cosmopotamian/scopefun-hardware/KiCadSource/file56A5A070.kicad_sch

## KiCad design KiCadSource/file56A5A070.kicad_sch (2025-03-08)

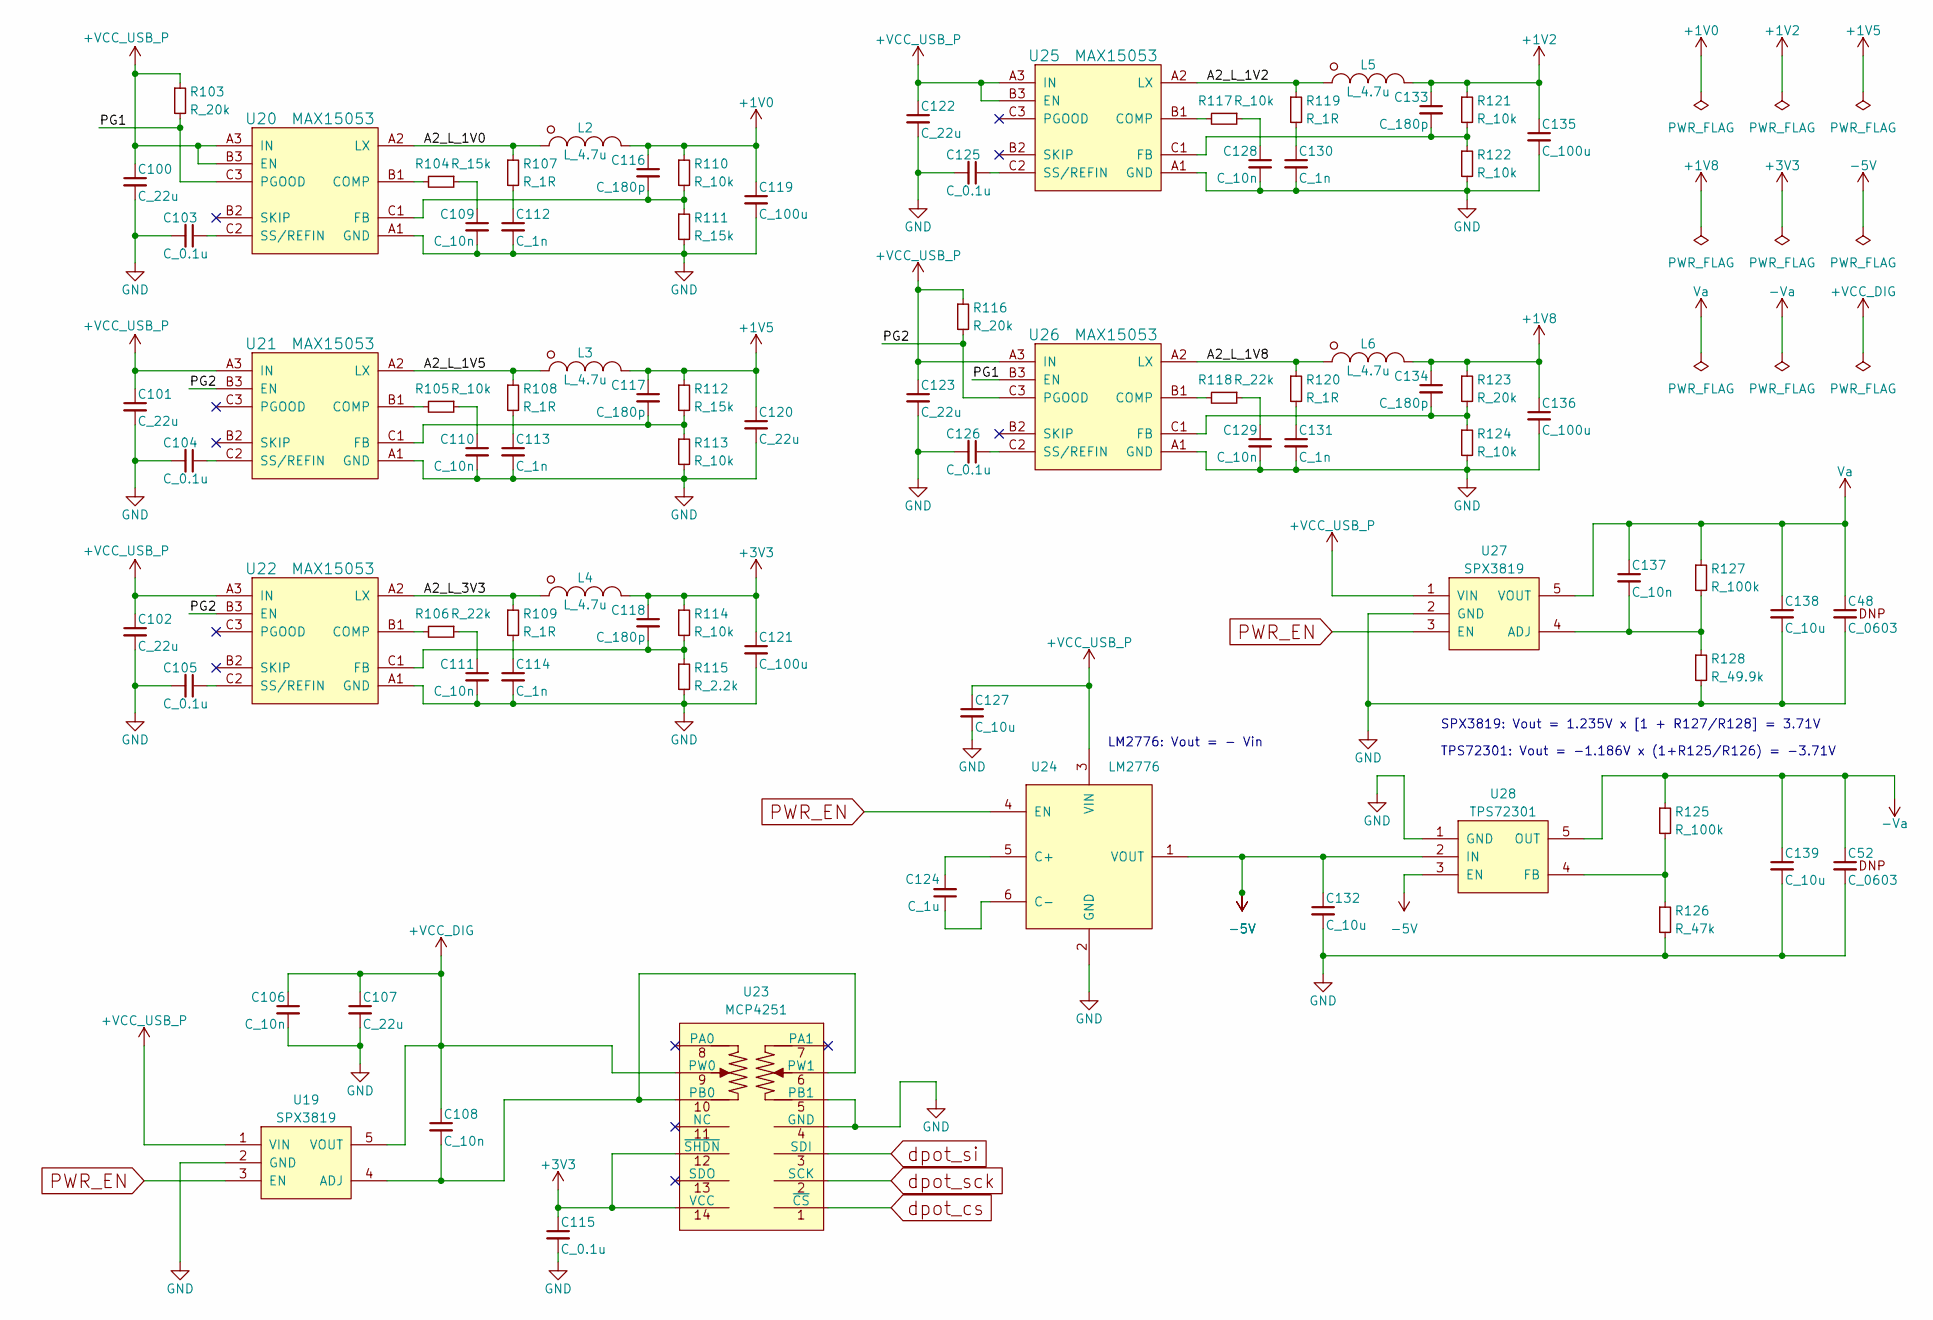
[picture p1: schematic file56A5A070.kicad_sch]

Parts:
C48, C52: C_0603
C100, C101, C102, C107, C120, C122, C123: C_22u; C_0805; MFG Part# LMK212BBJ226MG-T
C103, C104, C105, C115, C125, C126: C_0.1u; C_0603; MFG Part# C0603C104K4RACTU
C106: C_10n; C_0603; MFG Part# GCM188R72A103KA37J
C108, C109, C110, C111, C128, C129, C137: C_10n; C_0603; MFG Part# GRM1885C1H103JA01D
C112, C113, C114, C130, C131: C_1n; C_0603; MFG Part# C1608X7R1H102K080AE
C116, C117, C118, C133, C134: C_180p; C_0603; MFG Part# C0603C181J5GACTU
C119, C121, C135, C136: C_100u; C_1210; MFG Part# 12106D107MAT2A
C124: C_1u; C_0603; MFG Part# C0603C105K9PACTU
C127, C132, C138, C139: C_10u; C_0603; MFG Part# GRM188R60J106KE47D
L2, L3, L4, L5, L6: L_4.7u; L_NRS; MFG Part# NRS5030T4R7MMGJ
R103, R116, R123: R_20k; R_0603; MFG Part# ERJ-3EKF2002V
R104, R111, R112: R_15k; R_0603; MFG Part# ERJ-3EKF1502V
R105, R110, R113, R114, R117, R121, R122, R124: R_10k; R_0603; MFG Part# ERJ-3EKF1002V
R106, R118: R_22k; R_0603; MFG Part# ERJ-3EKF2202V
R107, R108, R109, R119, R120: R_1R; R_0603; MFG Part# ERJ-3GEYJ1R0V
R115: R_2.2k; R_0603; MFG Part# ERJ-3EKF2201V
R125, R127: R_100k; R_0603; MFG Part# ERJ-3EKF1003V
R126: R_47k; R_0603; MFG Part# ERJ-3EKF4702V
R128: R_49.9k; R_0603; MFG Part# ERJ-3EKF4992V
U19, U27: SPX3819; SOT23-5_EXAR; MFG Part# SPX3819M5-L/TR
U20, U21, U22, U25, U26: MAX15053; WLP-9; MFG Part# MAX15053EWL+T
U23: MCP4251; TSSOP14; MFG Part# MCP4251-503E/ST
U24: LM2776; SOT23-6; MFG Part# LM2776DBVR
U28: TPS72301; SOT23-5; MFG Part# TPS72301DBVR

Connections:
+1V0: C116.1, C119.1, L2.2, R110.1
+1V2: C133.1, C135.1, L5.2, R121.1
+1V5: C117.1, C120.1, L3.2, R112.1
+1V8: C134.1, C136.1, L6.2, R123.1
+3V3: C115.1, C118.1, C121.1, L4.2, R114.1, U23.12 (~SHDN), U23.14 (VCC)
+VCC_DIG: C106.1, C107.1, C108.1, U19.5 (VOUT), U23.9 (PW0)
+VCC_USB_P: C100.1, C101.1, C102.1, C122.1, C123.1, C127.1, R103.1, R116.1, U19.1 (VIN), U20.A3 (IN), U20.B3 (EN), U21.A3 (IN), U22.A3 (IN), U24.3 (VIN), U25.A3 (IN), U25.B3 (EN), U26.A3 (IN), U27.1 (VIN)
-5V: C132.1, U24.1 (VOUT), U28.2 (IN), U28.3 (EN)
-Va: C52.1, C139.1, R125.1, U28.5 (OUT)
A2_L_1V0: L2.1, R107.1, U20.A2 (LX)
A2_L_1V2: L5.1, R119.1, U25.A2 (LX)
A2_L_1V5: L3.1, R108.1, U21.A2 (LX)
A2_L_1V8: L6.1, R120.1, U26.A2 (LX)
A2_L_3V3: L4.1, R109.1, U22.A2 (LX)
GND: C48.2, C52.2, C100.2, C101.2, C102.2, C103.2, C104.2, C105.2, C106.2, C107.2, C109.2, C110.2, C111.2, C112.2, C113.2, C114.2, C115.2, C119.2, C120.2, C121.2, C122.2, C123.2, C125.2, C126.2, C127.2, C128.2, C129.2, C130.2, C131.2, C132.2, C135.2, C136.2, C138.2, C139.2, R111.2, R113.2, R115.2, R122.2, R124.2, R126.2, R128.2, U19.2 (GND), U20.A1 (GND), U21.A1 (GND), U22.A1 (GND), U23.4 (GND), U23.5 (PB1), U24.2 (GND), U25.A1 (GND), U26.A1 (GND), U27.2 (GND), U28.1 (GND)
unnamed: C103.1, U20.C2 (SS/REFIN)
unnamed: C104.1, U21.C2 (SS/REFIN)
unnamed: C105.1, U22.C2 (SS/REFIN)
unnamed: C108.2, U19.4 (ADJ), U23.6 (PW1), U23.10 (PB0)
unnamed: C109.1, R104.1
unnamed: C110.1, R105.1
unnamed: C111.1, R106.1
unnamed: C112.1, R107.2
unnamed: C113.1, R108.2
unnamed: C114.1, R109.2
unnamed: C116.2, R110.2, R111.1, U20.C1 (FB)
unnamed: C117.2, R112.2, R113.1, U21.C1 (FB)
unnamed: C118.2, R114.2, R115.1, U22.C1 (FB)
unnamed: C124.1, U24.6 (C-)
unnamed: C124.2, U24.5 (C+)
unnamed: C125.1, U25.C2 (SS/REFIN)
unnamed: C126.1, U26.C2 (SS/REFIN)
unnamed: C128.1, R117.1
unnamed: C129.1, R118.1
unnamed: C130.1, R119.2
unnamed: C131.1, R120.2
unnamed: C133.2, R121.2, R122.1, U25.C1 (FB)
unnamed: C134.2, R123.2, R124.1, U26.C1 (FB)
unnamed: C137.2, R127.2, R128.1, U27.4 (ADJ)
unnamed: R104.2, U20.B1 (COMP)
unnamed: R105.2, U21.B1 (COMP)
unnamed: R106.2, U22.B1 (COMP)
unnamed: R117.2, U25.B1 (COMP)
unnamed: R118.2, U26.B1 (COMP)
unnamed: R125.2, R126.1, U28.4 (FB)
PG1: R103.2, U20.C3 (PGOOD), U26.B3 (EN)
PG2: R116.2, U21.B3 (EN), U22.B3 (EN), U26.C3 (PGOOD)
PWR_EN: U19.3 (EN), U24.4 (EN), U27.3 (EN)
Va: C48.1, C137.1, C138.1, R127.1, U27.5 (VOUT)
dpot_cs: U23.1 (~CS)
dpot_sck: U23.2 (SCK)
dpot_si: U23.3 (SDI)

Notes on the sheet:
TPS72301: Vout = -1.186V x (1+R125/R126) = -3.71V
LM2776: Vout = - Vin
SPX3819: Vout = 1.235V x [1 + R127/R128] = 3.71V
