cosmopotamian/scopefun-hardware/KiCadSource/file56A1473D.kicad_sch

## KiCad design KiCadSource/file56A1473D.kicad_sch (2025-03-08)

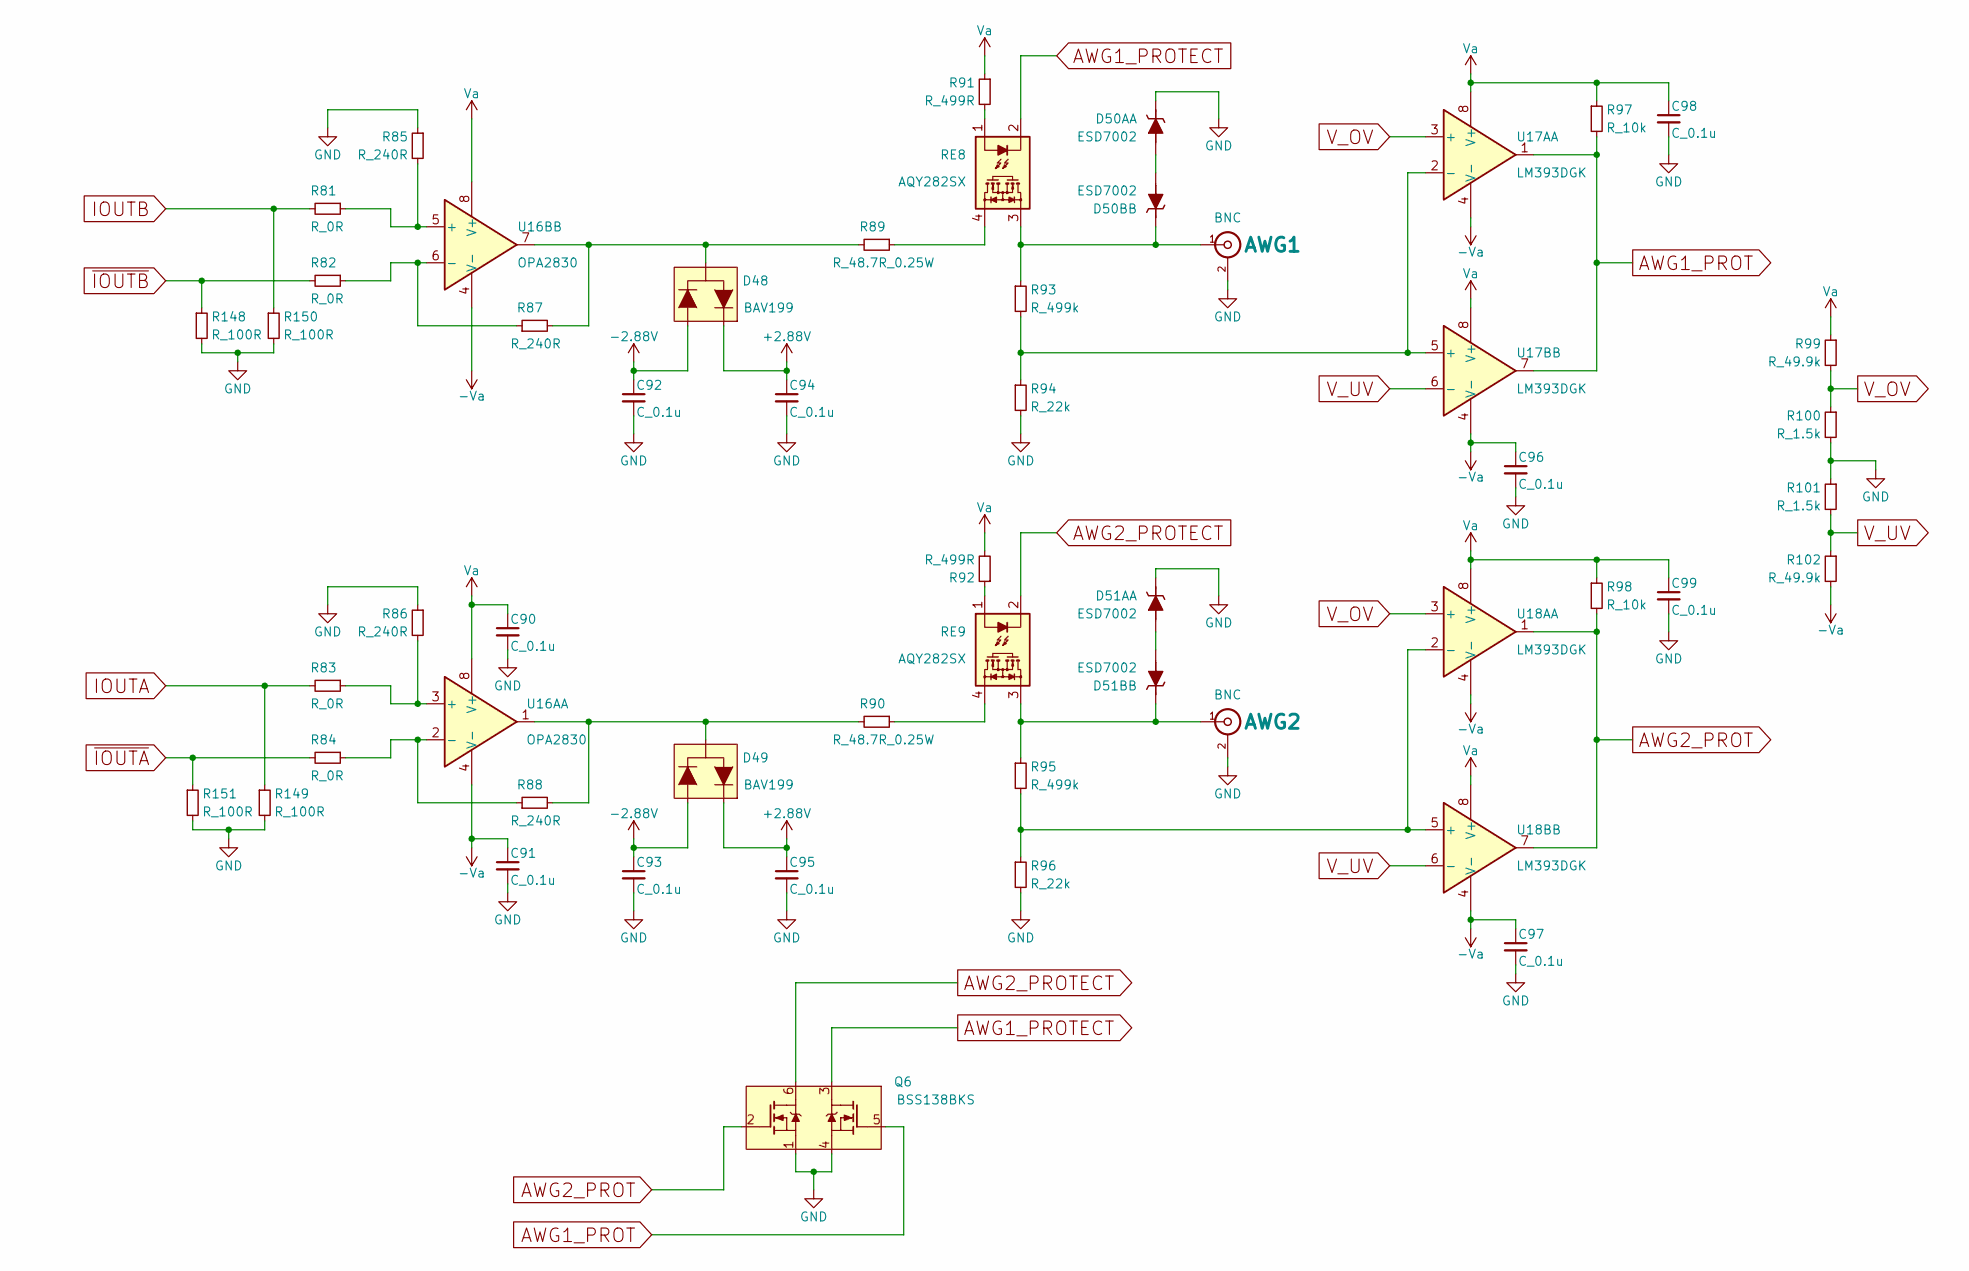
[picture p2: schematic file56A1473D.kicad_sch]

Parts:
AWG1, AWG2: BNC; BNC-5-1634556-0; MFG Part# 5-1634556-0
C90, C91, C92, C93, C94, C95, C96, C97, C98, C99: C_0.1u; C_0603; MFG Part# C0603C104K4RACTU
D48, D49: BAV199; SOT23; MFG Part# BAV199-7-F
D50A, D50B, D51A, D51B: ESD7002; SOT323; MFG Part# ESD7002WTT1G
Q6: BSS138BKS; SOT363; MFG Part# BSS138PS,115
R81, R82, R83, R84: R_0R; R_0603; MFG Part# RC0603JR-070RL
R85, R86, R87, R88: R_240R; R_0603; MFG Part# ERJ-3EKF2400V
R89, R90: R_48.7R_0.25W; R_1206; MFG Part# ERJ-8ENF48R7V
R91, R92: R_499R; R_0603; MFG Part# ERJ-3EKF4990V
R93, R95: R_499k; R_0603; MFG Part# ERJ-3EKF4993V
R94, R96: R_22k; R_0603; MFG Part# ERJ-3EKF2202V
R97, R98: R_10k; R_0603; MFG Part# ERJ-3EKF1002V
R99, R102: R_49.9k; R_0603; MFG Part# ERJ-3EKF4992V
R100, R101: R_1.5k; R_0603; MFG Part# ERJ-3EKF1501V
R148, R149, R150, R151: R_100R; R_0603; MFG Part# ERJ-3EKF1000V
RE8, RE9: AQY282SX; SOP-4; MFG Part# AQY282SX
U16A, U16B: OPA2830; TSSOP8; MFG Part# OPA2830IDGKT
U17A, U17B, U18A, U18B: LM393DGK; TSSOP8; MFG Part# LM393DGKR

Connections:
+2.88V: C94.1, C95.1, D48.2, D49.2
-2.88V: C92.1, C93.1, D48.1, D49.1
-Va: C91.1, C96.1, C97.1, R102.2, U16A.4 (V-), U16B.4 (V-), U17A.4 (V-), U17B.4 (V-), U18A.4 (V-), U18B.4 (V-)
AWG1_PROT: Q6.5 (G2), R97.2, U17A.1, U17B.7
AWG1_PROTECT: Q6.3 (D2), RE8.2
AWG2_PROT: Q6.2 (G1), R98.2, U18A.1, U18B.7
AWG2_PROTECT: Q6.6 (D1), RE9.2
GND: AWG1.2 (Ext), AWG2.2 (Ext), C90.2, C91.2, C92.2, C93.2, C94.2, C95.2, C96.2, C97.2, C98.2, C99.2, D50A.1 (C), D51A.1 (C), Q6.1 (S1), Q6.4 (S2), R85.1, R86.1, R94.2, R96.2, R100.2, R101.1, R148.2, R149.2, R150.2, R151.2
IOUTA: R83.2, R149.1
IOUTB: R81.2, R150.1
unnamed: AWG1.1 (In), D50B.2 (C), R93.1, RE8.3
unnamed: AWG2.1 (In), D51B.2 (C), R95.1, RE9.3
unnamed: D48.3, R87.2, R89.2, U16B.7
unnamed: D49.3, R88.2, R90.2, U16A.1
unnamed: D50A.3 (A), D50B.3 (A)
unnamed: D51A.3 (A), D51B.3 (A)
unnamed: R81.1, R85.2, U16B.5 (+)
unnamed: R82.1, R87.1, U16B.6 (-)
unnamed: R83.1, R86.2, U16A.3 (+)
unnamed: R84.1, R88.1, U16A.2 (-)
unnamed: R89.1, RE8.4
unnamed: R90.1, RE9.4
unnamed: R91.2, RE8.1
unnamed: R92.1, RE9.1
unnamed: R93.2, R94.1, U17A.2 (-), U17B.5 (+)
unnamed: R95.2, R96.1, U18A.2 (-), U18B.5 (+)
V_OV: R99.2, R100.1, U17A.3 (+), U18A.3 (+)
V_UV: R101.2, R102.1, U17B.6 (-), U18B.6 (-)
Va: C90.1, C98.1, C99.1, R91.1, R92.2, R97.1, R98.1, R99.1, U16A.8 (V+), U16B.8 (V+), U17A.8 (V+), U17B.8 (V+), U18A.8 (V+), U18B.8 (V+)
~IOUTA: R84.2, R151.1
~IOUTB: R82.2, R148.1
