cosmopotamian/scopefun-hardware/KiCadSource/file584EFEB1.kicad_sch

## KiCad design KiCadSource/file584EFEB1.kicad_sch (2025-03-08)

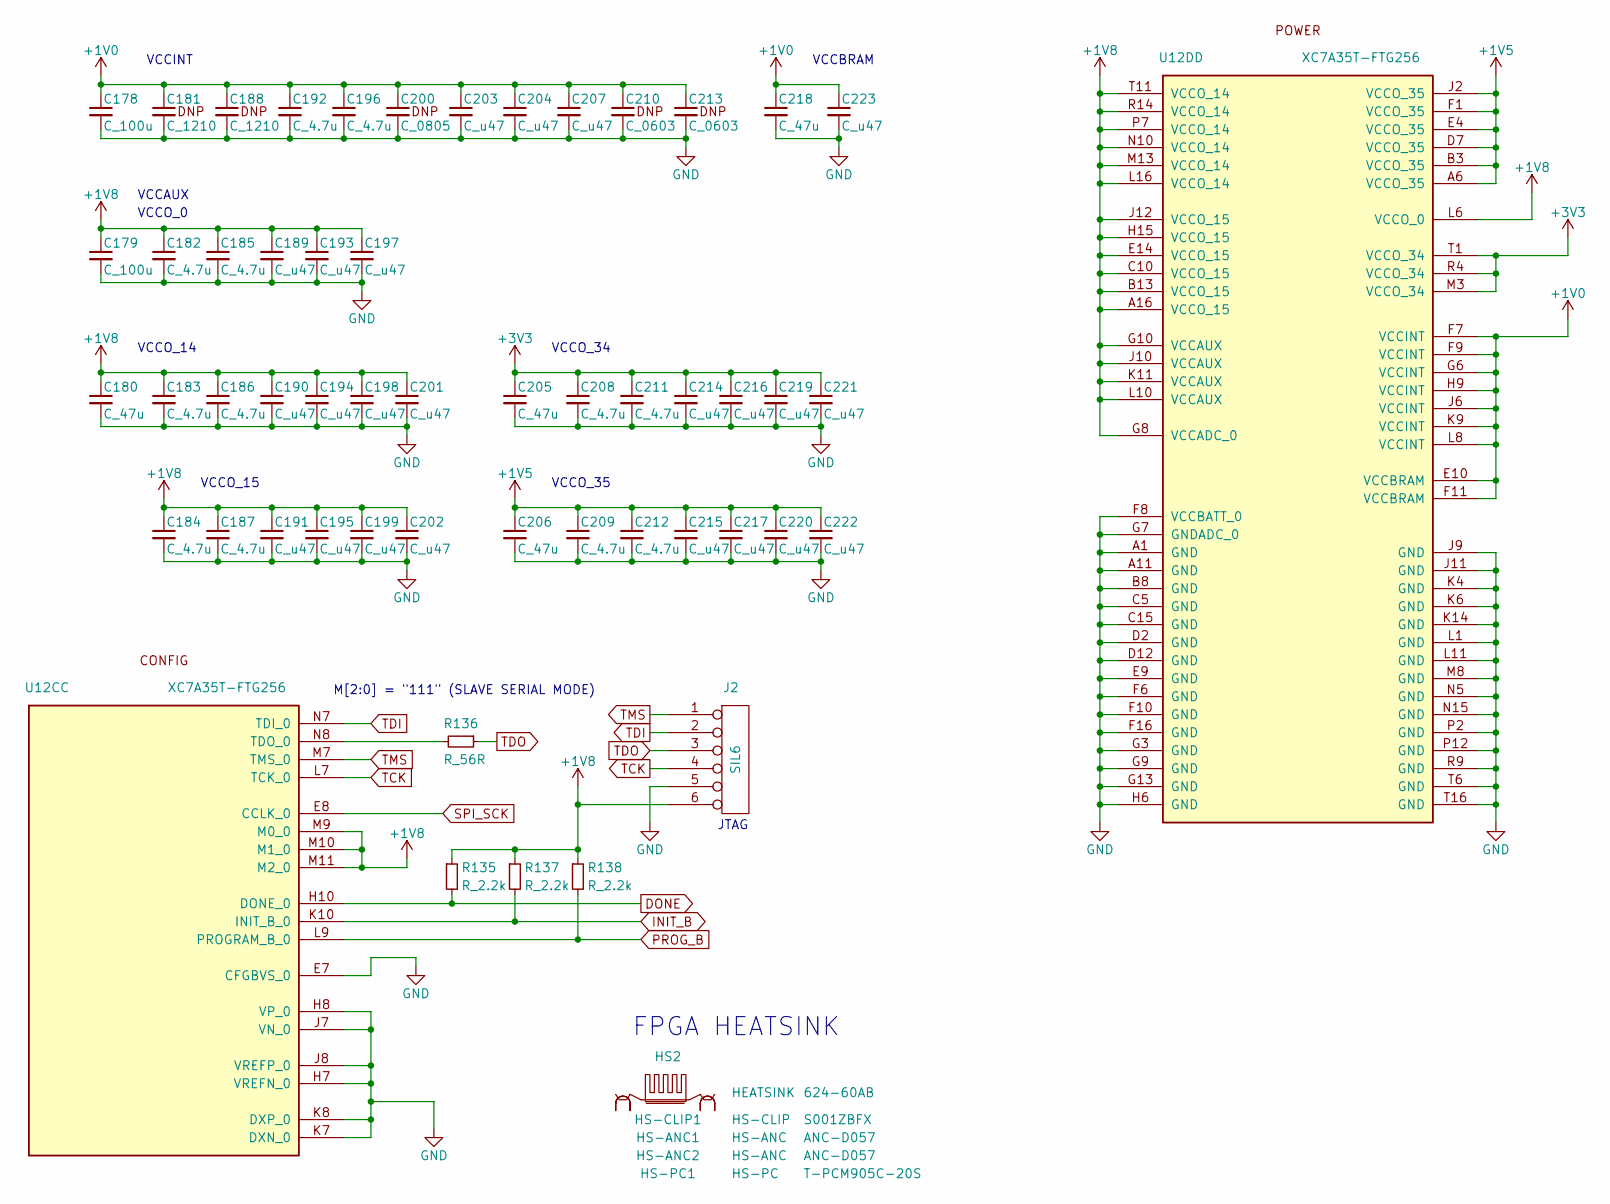
[picture p4: schematic file584EFEB1.kicad_sch]

Parts:
C178, C179: C_100u; C_1210; MFG Part# 12106D107MAT2A
C180, C205, C206, C218: C_47u; C_1210; MFG Part# LMK325BJ476MM-T
C181, C188: C_1210
C182, C183, C184, C185, C186, C187, C192, C196, C208, C209, C211, C212: C_4.7u; C_0805; MFG Part# C2012X7R1A475K125AC
C189, C190, C191, C193, C194, C195, C197, C198, C199, C201, C202, C203, C204, C207, C214, C215, C216, C217, C219, C220, C221, C222, C223: C_u47; C_0603; MFG Part# EMK107B7474KA-T
C200: C_0805
C210, C213: C_0603
HS2: HEATSINK; HS2; MFG Part# 624-60AB
HS-ANC1, HS-ANC2: HS-ANC; MFG Part# ANC-D057
HS-CLIP1: HS-CLIP; MFG Part# S001ZBFX
HS-PC1: HS-PC; MFG Part# T-PCM905C-20S
J2: SIL6; MFG Part# M20-9990645
R135, R137, R138: R_2.2k; R_0603; MFG Part# ERJ-3EKF2201V
R136: R_56R; R_0603; MFG Part# ERJ-3EKF56R0V
U12C, U12D: XC7A35T-FTG256; BGA256_FTG256; MFG Part# XC7A35T-2FTG256I

Connections:
+1V0: C178.1, C181.1, C188.1, C192.1, C196.1, C200.1, C203.1, C204.1, C207.1, C210.1, C213.1, C218.1, C223.1, U12D.E10 (VCCBRAM), U12D.F7 (VCCINT), U12D.F9 (VCCINT), U12D.F11 (VCCBRAM), U12D.G6 (VCCINT), U12D.H9 (VCCINT), U12D.J6 (VCCINT), U12D.K9 (VCCINT), U12D.L8 (VCCINT)
+1V5: C206.1, C209.1, C212.1, C215.1, C217.1, C220.1, C222.1, U12D.A6 (VCCO_35), U12D.B3 (VCCO_35), U12D.D7 (VCCO_35), U12D.E4 (VCCO_35), U12D.F1 (VCCO_35), U12D.J2 (VCCO_35)
+1V8: C179.1, C180.1, C182.1, C183.1, C184.1, C185.1, C186.1, C187.1, C189.1, C190.1, C191.1, C193.1, C194.1, C195.1, C197.1, C198.1, C199.1, C201.1, C202.1, J2.6, R135.1, R137.1, R138.1, U12C.M9 (M0_0), U12C.M10 (M1_0), U12C.M11 (M2_0), U12D.A16 (VCCO_15), U12D.B13 (VCCO_15), U12D.C10 (VCCO_15), U12D.E14 (VCCO_15), U12D.G8 (VCCADC_0), U12D.G10 (VCCAUX), U12D.H15 (VCCO_15), U12D.J10 (VCCAUX), U12D.J12 (VCCO_15), U12D.K11 (VCCAUX), U12D.L6 (VCCO_0), U12D.L10 (VCCAUX), U12D.L16 (VCCO_14), U12D.M13 (VCCO_14), U12D.N10 (VCCO_14), U12D.P7 (VCCO_14), U12D.R14 (VCCO_14), U12D.T11 (VCCO_14)
+3V3: C205.1, C208.1, C211.1, C214.1, C216.1, C219.1, C221.1, U12D.M3 (VCCO_34), U12D.R4 (VCCO_34), U12D.T1 (VCCO_34)
DONE: R135.2, U12C.H10 (DONE_0)
GND: C178.2, C179.2, C180.2, C181.2, C182.2, C183.2, C184.2, C185.2, C186.2, C187.2, C188.2, C189.2, C190.2, C191.2, C192.2, C193.2, C194.2, C195.2, C196.2, C197.2, C198.2, C199.2, C200.2, C201.2, C202.2, C203.2, C204.2, C205.2, C206.2, C207.2, C208.2, C209.2, C210.2, C211.2, C212.2, C213.2, C214.2, C215.2, C216.2, C217.2, C218.2, C219.2, C220.2, C221.2, C222.2, C223.2, J2.5, U12C.E7 (CFGBVS_0), U12C.H7 (VREFN_0), U12C.H8 (VP_0), U12C.J7 (VN_0), U12C.J8 (VREFP_0), U12C.K7 (DXN_0), U12C.K8 (DXP_0), U12D.A1 (GND), U12D.A11 (GND), U12D.B8 (GND), U12D.C5 (GND), U12D.C15 (GND), U12D.D2 (GND), U12D.D12 (GND), U12D.E9 (GND), U12D.F6 (GND), U12D.F8 (VCCBATT_0), U12D.F10 (GND), U12D.F16 (GND), U12D.G3 (GND), U12D.G7 (GNDADC_0), U12D.G9 (GND), U12D.G13 (GND), U12D.H6 (GND), U12D.J9 (GND), U12D.J11 (GND), U12D.K4 (GND), U12D.K6 (GND), U12D.K14 (GND), U12D.L1 (GND), U12D.L11 (GND), U12D.M8 (GND), U12D.N5 (GND), U12D.N15 (GND), U12D.P2 (GND), U12D.P12 (GND), U12D.R9 (GND), U12D.T6 (GND), U12D.T16 (GND)
INIT_B: R137.2, U12C.K10 (INIT_B_0)
unnamed: R136.2, U12C.N8 (TDO_0)
PROG_B: R138.2, U12C.L9 (PROGRAM_B_0)
SPI_SCK: U12C.E8 (CCLK_0)
TCK: J2.4, U12C.L7 (TCK_0)
TDI: J2.2, U12C.N7 (TDI_0)
TDO: J2.3, R136.1
TMS: J2.1, U12C.M7 (TMS_0)

Notes on the sheet:
VCCO_35
VCCO_14
FPGA HEATSINK
M[2:0] = "111" (SLAVE SERIAL MODE)
JTAG
VCCO_0
VCCINT
VCCO_34
VCCBRAM
VCCAUX
VCCO_15
