cosmopotamian/scopefun-hardware/KiCadSource/file5696EC3B.kicad_sch

## KiCad design KiCadSource/file5696EC3B.kicad_sch (2025-03-08)

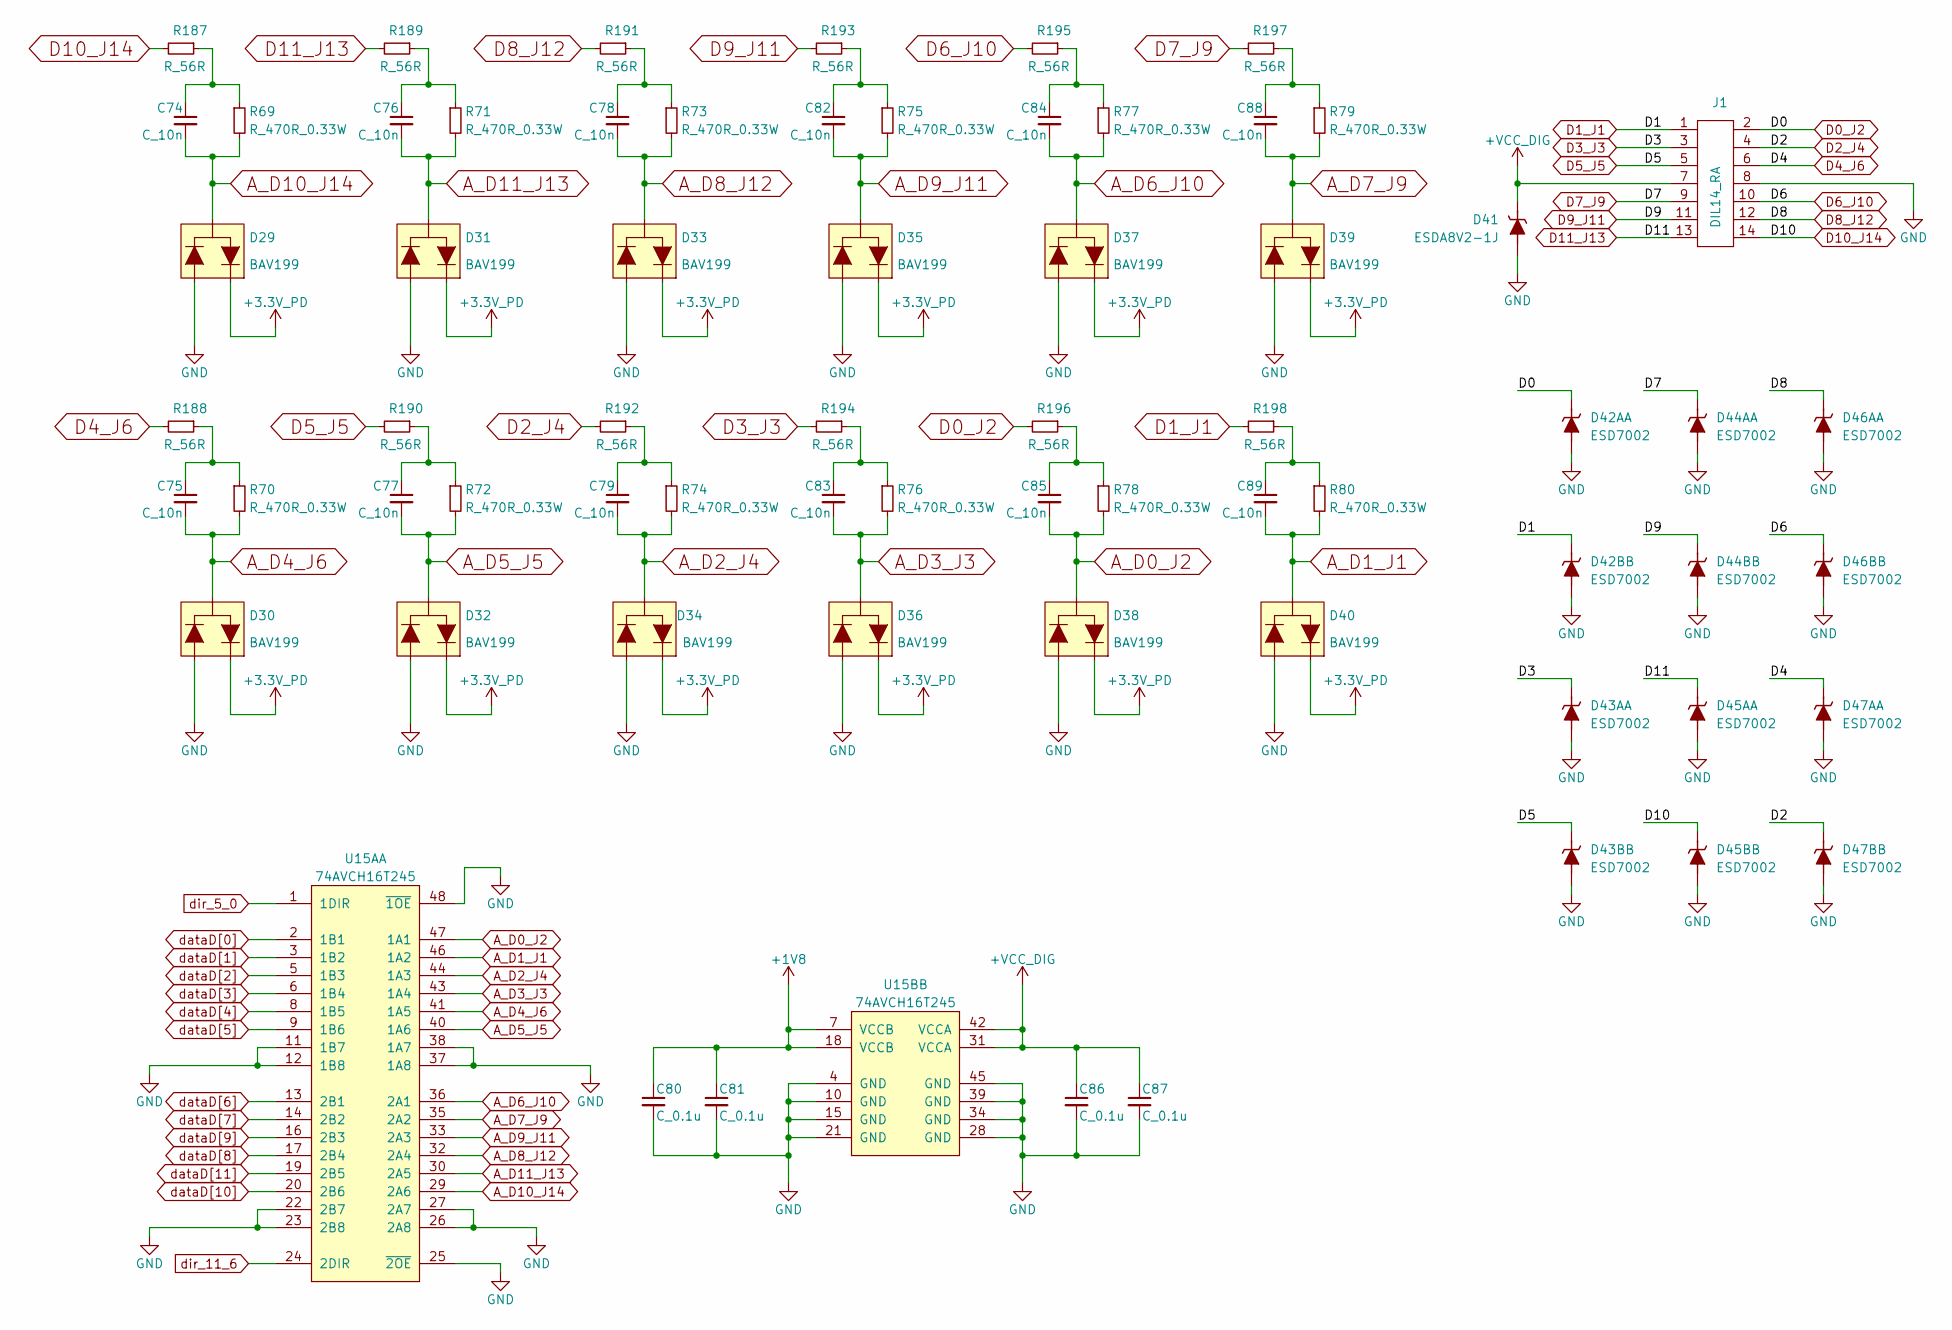
[picture p5: schematic file5696EC3B.kicad_sch]

Parts:
C74, C75, C76, C77, C78, C79, C82, C83, C84, C85, C88, C89: C_10n; C_0603; MFG Part# GCM188R72A103KA37J
C80, C81, C86, C87: C_0.1u; C_0603; MFG Part# C0603C104K4RACTU
D29, D30, D31, D32, D33, D34, D35, D36, D37, D38, D39, D40: BAV199; SOT23; MFG Part# BAV199-7-F
D41: ESDA8V2-1J; SOD323; MFG Part# ESDA8V2-1J
D42A, D42B, D43A, D43B, D44A, D44B, D45A, D45B, D46A, D46B, D47A, D47B: ESD7002; SOT323; MFG Part# ESD7002WTT1G
J1: DIL14_RA; MFG Part# 61201421721
R69, R70, R71, R72, R73, R74, R75, R76, R77, R78, R79, R80: R_470R_0.33W; R_0603; MFG Part# SG73P1JTTD4700F
R187, R188, R189, R190, R191, R192, R193, R194, R195, R196, R197, R198: R_56R; R_0603; MFG Part# ERJ-3EKF56R0V
U15A, U15B: 74AVCH16T245; TSSOP48; MFG Part# SN74AVCH16T245GR

Connections:
+1V8: C80.1, C81.1, U15B.7 (VCCB), U15B.18 (VCCB)
+3.3V_PD: D29.2, D30.2, D31.2, D32.2, D33.2, D34.2, D35.2, D36.2, D37.2, D38.2, D39.2, D40.2
+VCC_DIG: C86.1, C87.1, D41.1 (C), J1.7, U15B.31 (VCCA), U15B.42 (VCCA)
A_D0_J2: C85.2, D38.3, R78.2, U15A.47 (1A1)
A_D1_J1: C89.2, D40.3, R80.2, U15A.46 (1A2)
A_D2_J4: C79.2, D34.3, R74.2, U15A.44 (1A3)
A_D3_J3: C83.2, D36.3, R76.2, U15A.43 (1A4)
A_D4_J6: C75.2, D30.3, R70.2, U15A.41 (1A5)
A_D5_J5: C77.2, D32.3, R72.2, U15A.40 (1A6)
A_D6_J10: C84.2, D37.3, R77.2, U15A.36 (2A1)
A_D7_J9: C88.2, D39.3, R79.2, U15A.35 (2A2)
A_D8_J12: C78.2, D33.3, R73.2, U15A.32 (2A4)
A_D9_J11: C82.2, D35.3, R75.2, U15A.33 (2A3)
A_D10_J14: C74.2, D29.3, R69.2, U15A.29 (2A6)
A_D11_J13: C76.2, D31.3, R71.2, U15A.30 (2A5)
D0_J2: D42A.1 (C), J1.2, R196.2
D1_J1: D42B.2 (C), J1.1, R198.2
D2_J4: D47B.2 (C), J1.4, R192.2
D3_J3: D43A.1 (C), J1.3, R194.2
D4_J6: D47A.1 (C), J1.6, R188.2
D5_J5: D43B.2 (C), J1.5, R190.2
D6_J10: D46B.2 (C), J1.10, R195.2
D7_J9: D44A.1 (C), J1.9, R197.2
D8_J12: D46A.1 (C), J1.12, R191.2
D9_J11: D44B.2 (C), J1.11, R193.2
D10_J14: D45B.2 (C), J1.14, R187.2
D11_J13: D45A.1 (C), J1.13, R189.2
GND: C80.2, C81.2, C86.2, C87.2, D29.1, D30.1, D31.1, D32.1, D33.1, D34.1, D35.1, D36.1, D37.1, D38.1, D39.1, D40.1, D41.2 (A), D42A.3 (A), D42B.3 (A), D43A.3 (A), D43B.3 (A), D44A.3 (A), D44B.3 (A), D45A.3 (A), D45B.3 (A), D46A.3 (A), D46B.3 (A), D47A.3 (A), D47B.3 (A), J1.8, U15A.11 (1B7), U15A.12 (1B8), U15A.22 (2B7), U15A.23 (2B8), U15A.25 (~2OE), U15A.26 (2A8), U15A.27 (2A7), U15A.37 (1A8), U15A.38 (1A7), U15A.48 (~1OE), U15B.4 (GND), U15B.10 (GND), U15B.15 (GND), U15B.21 (GND), U15B.28 (GND), U15B.34 (GND), U15B.39 (GND), U15B.45 (GND)
unnamed: C74.1, R69.1, R187.1
unnamed: C75.1, R70.1, R188.1
unnamed: C76.1, R71.1, R189.1
unnamed: C77.1, R72.1, R190.1
unnamed: C78.1, R73.1, R191.1
unnamed: C79.1, R74.1, R192.1
unnamed: C82.1, R75.1, R193.1
unnamed: C83.1, R76.1, R194.1
unnamed: C84.1, R77.1, R195.1
unnamed: C85.1, R78.1, R196.1
unnamed: C88.1, R79.1, R197.1
unnamed: C89.1, R80.1, R198.1
dataD[0]: U15A.2 (1B1)
dataD[1]: U15A.3 (1B2)
dataD[2]: U15A.5 (1B3)
dataD[3]: U15A.6 (1B4)
dataD[4]: U15A.8 (1B5)
dataD[5]: U15A.9 (1B6)
dataD[6]: U15A.13 (2B1)
dataD[7]: U15A.14 (2B2)
dataD[8]: U15A.17 (2B4)
dataD[9]: U15A.16 (2B3)
dataD[10]: U15A.20 (2B6)
dataD[11]: U15A.19 (2B5)
dir_5_0: U15A.1 (1DIR)
dir_11_6: U15A.24 (2DIR)
