cosmopotamian/scopefun-hardware/KiCadSource/file5855FC3A.kicad_sch

## KiCad design KiCadSource/file5855FC3A.kicad_sch (2025-03-08)

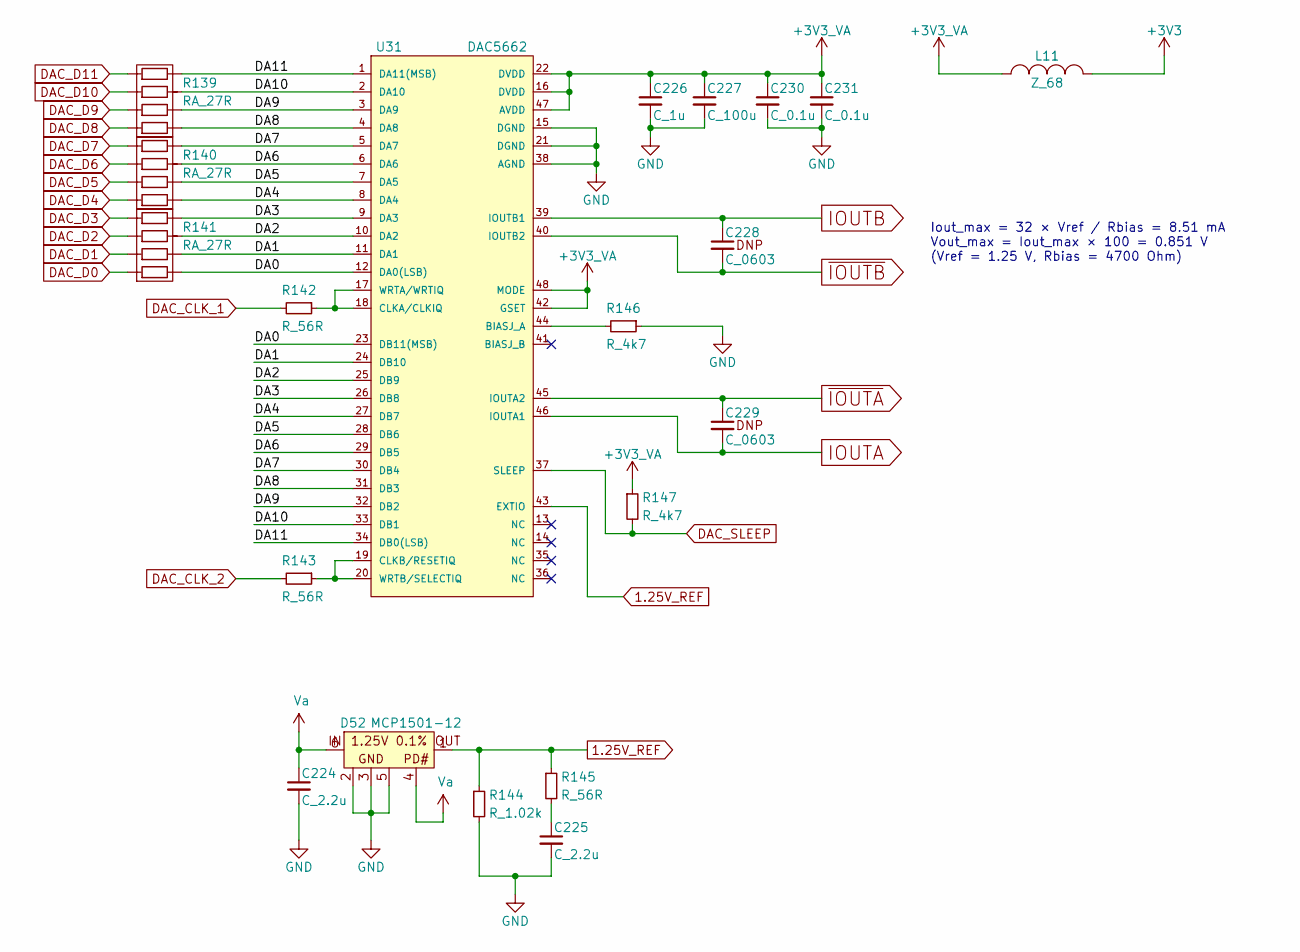
[picture p6: schematic file5855FC3A.kicad_sch]

Parts:
C224, C225: C_2.2u; C_0603; MFG Part# CC0603MRX5R5BB225
C226: C_1u; C_0603; MFG Part# C0603C105K9PACTU
C227: C_100u; C_1210; MFG Part# 12106D107MAT2A
C228, C229: C_0603
C230, C231: C_0.1u; C_0603; MFG Part# C0603C104K4RACTU
D52: MCP1501-12; SOT23-6; MFG Part# MCP1501T-12E/CHY
L11: Z_68; L_0805; MFG Part# 782853680
R139, R140, R141: RA_27R; R_CRA06E; MFG Part# YC164-JR-0727RL
R142, R143, R145: R_56R; R_0603; MFG Part# ERJ-3EKF56R0V
R144: R_1.02k; R_0603; MFG Part# ERJ-3EKF1021V
R146, R147: R_4k7; R_0603; MFG Part# ERJ-3EKF4701V
U31: DAC5662; S-PQFP-G48; MFG Part# DAC5662IPFB

Connections:
1.25V_REF: D52.1 (OUT), R144.1, R145.1, U31.43 (EXTIO)
+3V3: L11.2
+3V3_VA: C226.1, C227.1, C230.1, C231.1, L11.1, R147.1, U31.16 (DVDD), U31.22 (DVDD), U31.42 (GSET), U31.47 (AVDD), U31.48 (MODE)
DA0: R141.1, U31.12 (DA0(LSB)), U31.23 (DB11(MSB))
DA1: R141.2, U31.11 (DA1), U31.24 (DB10)
DA2: R141.3, U31.10 (DA2), U31.25 (DB9)
DA3: R141.4, U31.9 (DA3), U31.26 (DB8)
DA4: R140.1, U31.8 (DA4), U31.27 (DB7)
DA5: R140.2, U31.7 (DA5), U31.28 (DB6)
DA6: R140.3, U31.6 (DA6), U31.29 (DB5)
DA7: R140.4, U31.5 (DA7), U31.30 (DB4)
DA8: R139.1, U31.4 (DA8), U31.31 (DB3)
DA9: R139.2, U31.3 (DA9), U31.32 (DB2)
DA10: R139.3, U31.2 (DA10), U31.33 (DB1)
DA11: R139.4, U31.1 (DA11(MSB)), U31.34 (DB0(LSB))
DAC_CLK_1: R142.2
DAC_CLK_2: R143.2
DAC_D0: R141.8
DAC_D1: R141.7
DAC_D2: R141.6
DAC_D3: R141.5
DAC_D4: R140.8
DAC_D5: R140.7
DAC_D6: R140.6
DAC_D7: R140.5
DAC_D8: R139.8
DAC_D9: R139.7
DAC_D10: R139.6
DAC_D11: R139.5
DAC_SLEEP: R147.2, U31.37 (SLEEP)
GND: C224.2, C225.2, C226.2, C227.2, C230.2, C231.2, D52.2 (GND), D52.3 (GND), D52.5 (GND), R144.2, R146.1, U31.15 (DGND), U31.21 (DGND), U31.38 (AGND)
IOUTA: C229.2, U31.46 (IOUTA1)
IOUTB: C228.1, U31.39 (IOUTB1)
unnamed: C225.1, R145.2
unnamed: R142.1, U31.17 (WRTA/WRTIQ), U31.18 (CLKA/CLKIQ)
unnamed: R143.1, U31.19 (CLKB/RESETIQ), U31.20 (WRTB/SELECTIQ)
unnamed: R146.2, U31.44 (BIASJ_A)
Va: C224.1, D52.4 (SHDN#), D52.6 (VDD)
~IOUTA: C229.1, U31.45 (IOUTA2)
~IOUTB: C228.2, U31.40 (IOUTB2)

Notes on the sheet:
Iout_max = 32 × Vref / Rbias = 8.51 mA Vout_max = Iout_max × 100 = 0.851 V (Vref = 1.25 V, Rbias = 4700 Ohm)
