cosmopotamian/scopefun-hardware/KiCadSource/file56770A0B.kicad_sch

## KiCad design KiCadSource/file56770A0B.kicad_sch (2025-03-08)

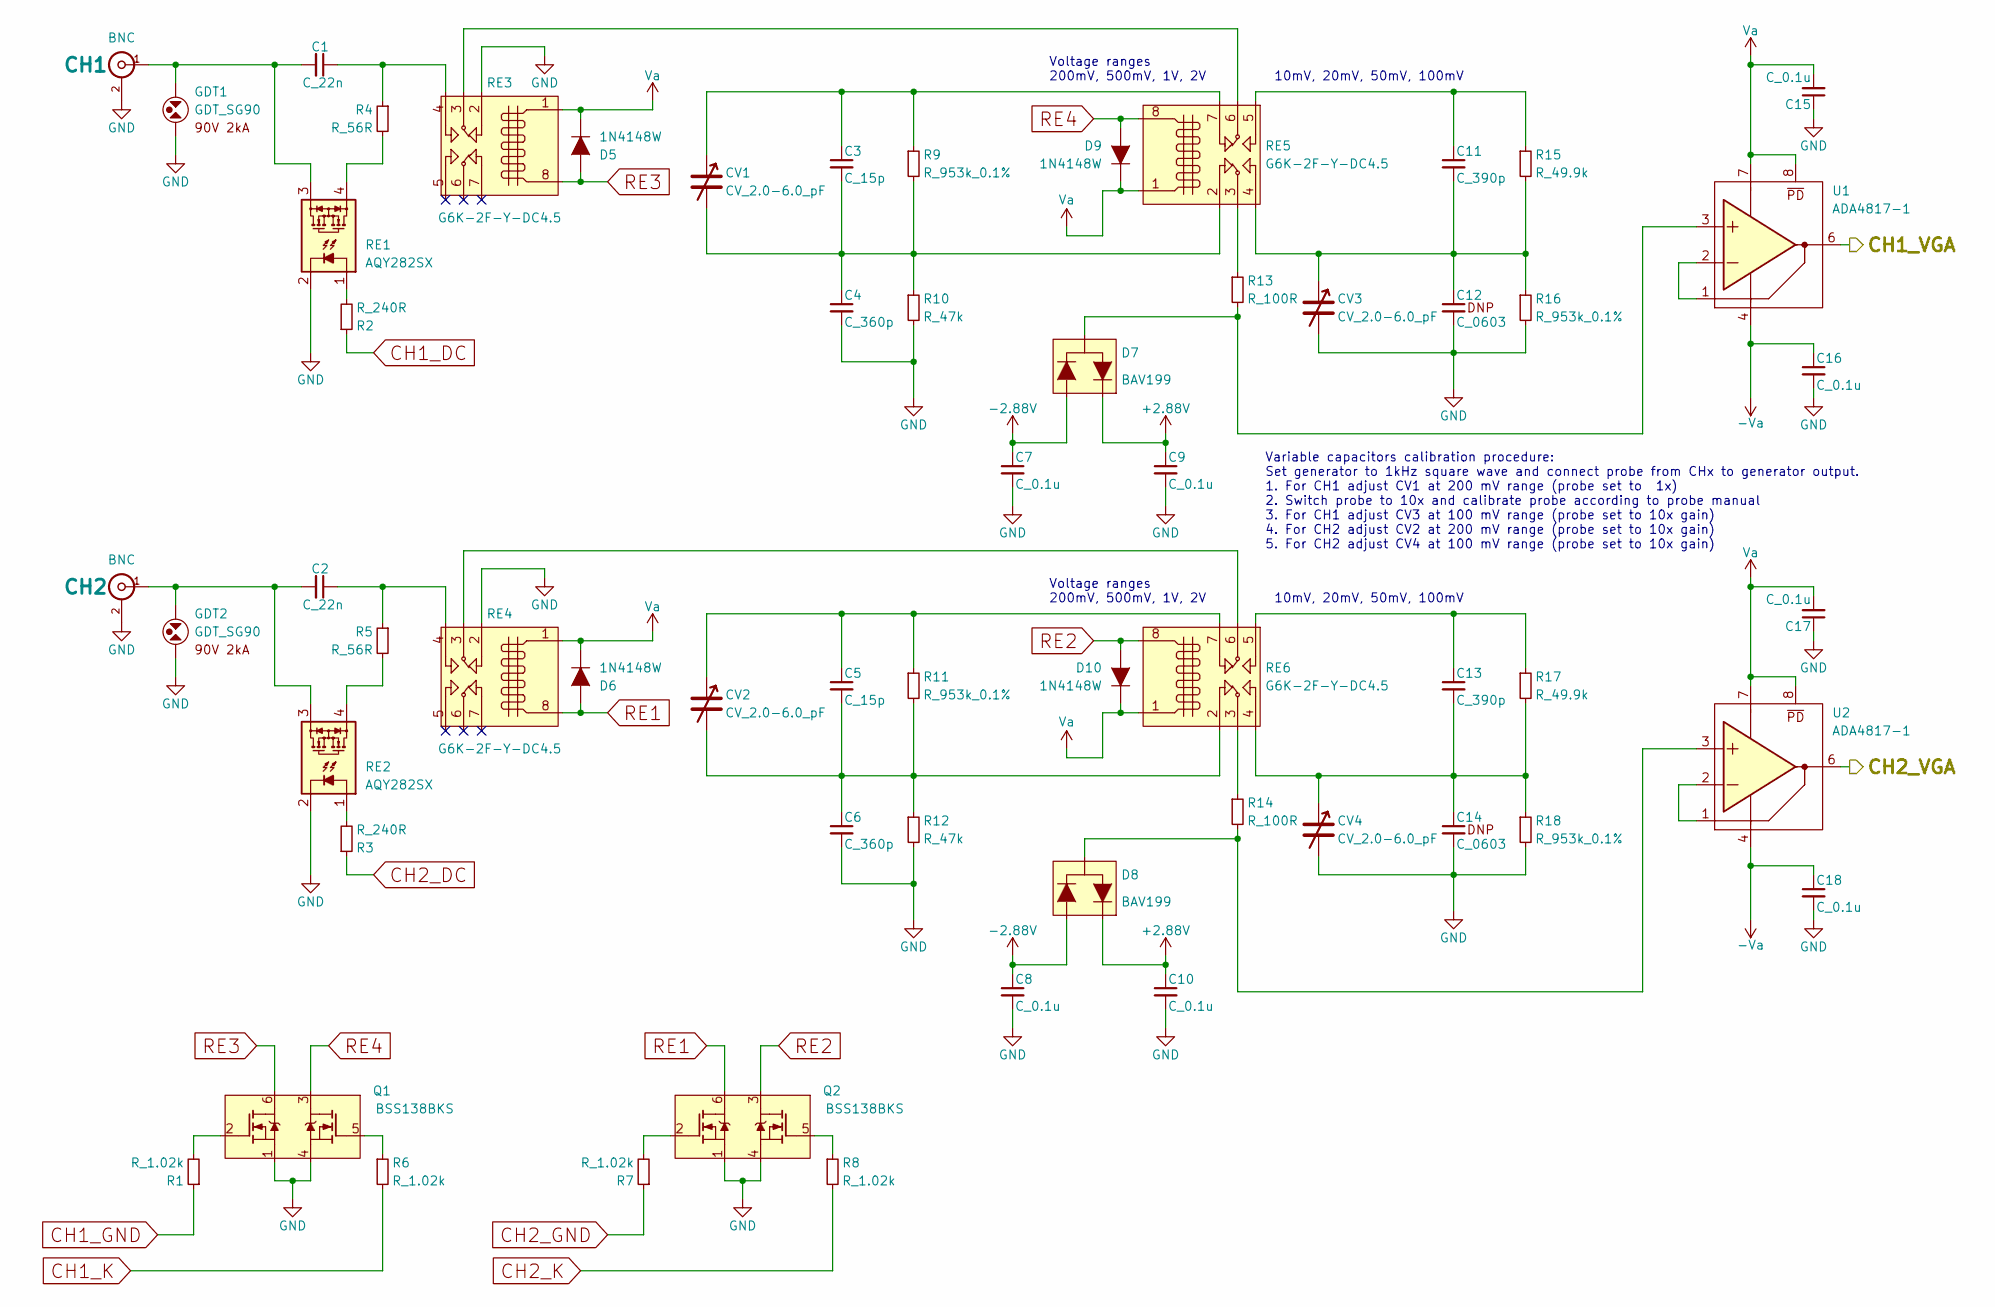
[picture p7: schematic file56770A0B.kicad_sch]

Parts:
C1, C2: C_22n; C_0603; MFG Part# C0603C223K1RACTU
C3, C5: C_15p; C_0603; MFG Part# 885012006074
C4, C6: C_360p; C_0603; MFG Part# C0603C361G5GACTU
C7, C8, C9, C10, C15, C16, C17, C18: C_0.1u; C_0603; MFG Part# C0603C104K4RACTU
C11, C13: C_390p; C_0603; MFG Part# VJ0603A391GXAPW1BC
C12, C14: C_0603
CH1, CH2: BNC; BNC-5-1634556-0; MFG Part# 5-1634556-0
CV1, CV2, CV3, CV4: CV_2.0-6.0_pF; SGC3; MFG Part# SGC3S060
D5, D6, D9, D10: 1N4148W; SOD123; MFG Part# 1N4148W-7-F
D7, D8: BAV199; SOT23; MFG Part# BAV199-7-F
GDT1, GDT2: GDT_SG90; GDT_SG; MFG Part# SG90
Q1, Q2: BSS138BKS; SOT363; MFG Part# BSS138PS,115
R1, R6, R7, R8: R_1.02k; R_0603; MFG Part# ERJ-3EKF1021V
R2, R3: R_240R; R_0603; MFG Part# ERJ-3EKF2400V
R4, R5: R_56R; R_0603; MFG Part# ERJ-3EKF56R0V
R9, R11, R16, R18: R_953k_0.1%; R_0805; MFG Part# ERA-6AEB9533V
R10, R12: R_47k; R_0603; MFG Part# ERJ-3EKF4702V
R13, R14: R_100R; R_0603; MFG Part# ERJ-3EKF1000V
R15, R17: R_49.9k; R_0603; MFG Part# ERJ-3EKF4992V
RE1, RE2: AQY282SX; SOP-4; MFG Part# AQY282SX
RE3, RE4, RE5, RE6: G6K-2F-Y-DC4.5; G6K-2F-Y; MFG Part# G6K-2F-Y-DC4.5
U1, U2: ADA4817-1; SOIC8; MFG Part# ADA4817-1ARDZ

Connections:
+2.88V: C9.1, C10.1, D7.2, D8.2
-2.88V: C7.1, C8.1, D7.1, D8.1
-Va: C16.1, C18.1, U1.4 (-Vs), U2.4 (-Vs)
CH1_DC: R2.1
CH1_GND: R1.1
CH1_K: R6.2
CH1_VGA: U1.6 (OUT)
CH2_DC: R3.1
CH2_GND: R7.1
CH2_K: R8.2
CH2_VGA: U2.6 (OUT)
GND: C4.2, C6.2, C7.2, C8.2, C9.2, C10.2, C12.2, C14.2, C15.1, C16.2, C17.1, C18.2, CH1.2 (Ext), CH2.2 (Ext), CV3.2, CV4.2, GDT1.2, GDT2.2, Q1.1 (S1), Q1.4 (S2), Q2.1 (S1), Q2.4 (S2), R10.2, R12.2, R16.2, R18.2, RE1.2, RE2.2, RE3.2, RE4.2
unnamed: C1.1, R4.1, RE3.4
unnamed: C1.2, CH1.1 (In), GDT1.1, RE1.3
unnamed: C2.1, R5.1, RE4.4
unnamed: C2.2, CH2.1 (In), GDT2.1, RE2.3
unnamed: C3.1, CV1.1, R9.1, RE5.7
unnamed: C3.2, C4.1, CV1.2, R9.2, R10.1, RE5.2
unnamed: C5.1, CV2.1, R11.1, RE6.7
unnamed: C5.2, C6.1, CV2.2, R11.2, R12.1, RE6.2
unnamed: C11.1, R15.1, RE5.5
unnamed: C11.2, C12.1, CV3.1, R15.2, R16.1, RE5.4
unnamed: C13.1, R17.1, RE6.5
unnamed: C13.2, C14.1, CV4.1, R17.2, R18.1, RE6.4
unnamed: D7.3, R13.2, U1.3 (+IN)
unnamed: D8.3, R14.2, U2.3 (+IN)
unnamed: Q1.2 (G1), R1.2
unnamed: Q1.5 (G2), R6.1
unnamed: Q2.2 (G1), R7.2
unnamed: Q2.5 (G2), R8.1
unnamed: R2.2, RE1.1
unnamed: R3.2, RE2.1
unnamed: R4.2, RE1.4
unnamed: R5.2, RE2.4
unnamed: R13.1, RE5.3
unnamed: R14.1, RE6.3
unnamed: RE3.3, RE5.6
unnamed: RE4.3, RE6.6
unnamed: U1.1 (FB), U1.2 (-IN)
unnamed: U2.1 (FB), U2.2 (-IN)
RE1: D6.2 (A), Q2.6 (D1), RE4.8
RE2: D10.2 (A), Q2.3 (D2), RE6.8
RE3: D5.2 (A), Q1.6 (D1), RE3.8
RE4: D9.2 (A), Q1.3 (D2), RE5.8
Va: C15.2, C17.2, D5.1 (K), D6.1 (K), D9.1 (K), D10.1 (K), RE3.1, RE4.1, RE5.1, RE6.1, U1.7 (+Vs), U1.8 (~PD), U2.7 (+Vs), U2.8 (~PD)

Notes on the sheet:
10mV, 20mV, 50mV, 100mV
Variable capacitors calibration procedure: Set generator to 1kHz square wave and connect probe from CHx to generator output. 1. For CH1 adjust CV1 at 200 mV range (probe set to 1x) 2. Switch probe to 10x and calibrate probe according to probe manual 3. For CH1 adjust CV3 at 100 mV range (probe set 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
Voltage ranges 200mV, 500mV, 1V, 2V
