cosmopotamian/scopefun-hardware/KiCadSource/file56785EF9.kicad_sch

## KiCad design KiCadSource/file56785EF9.kicad_sch (2025-03-08)

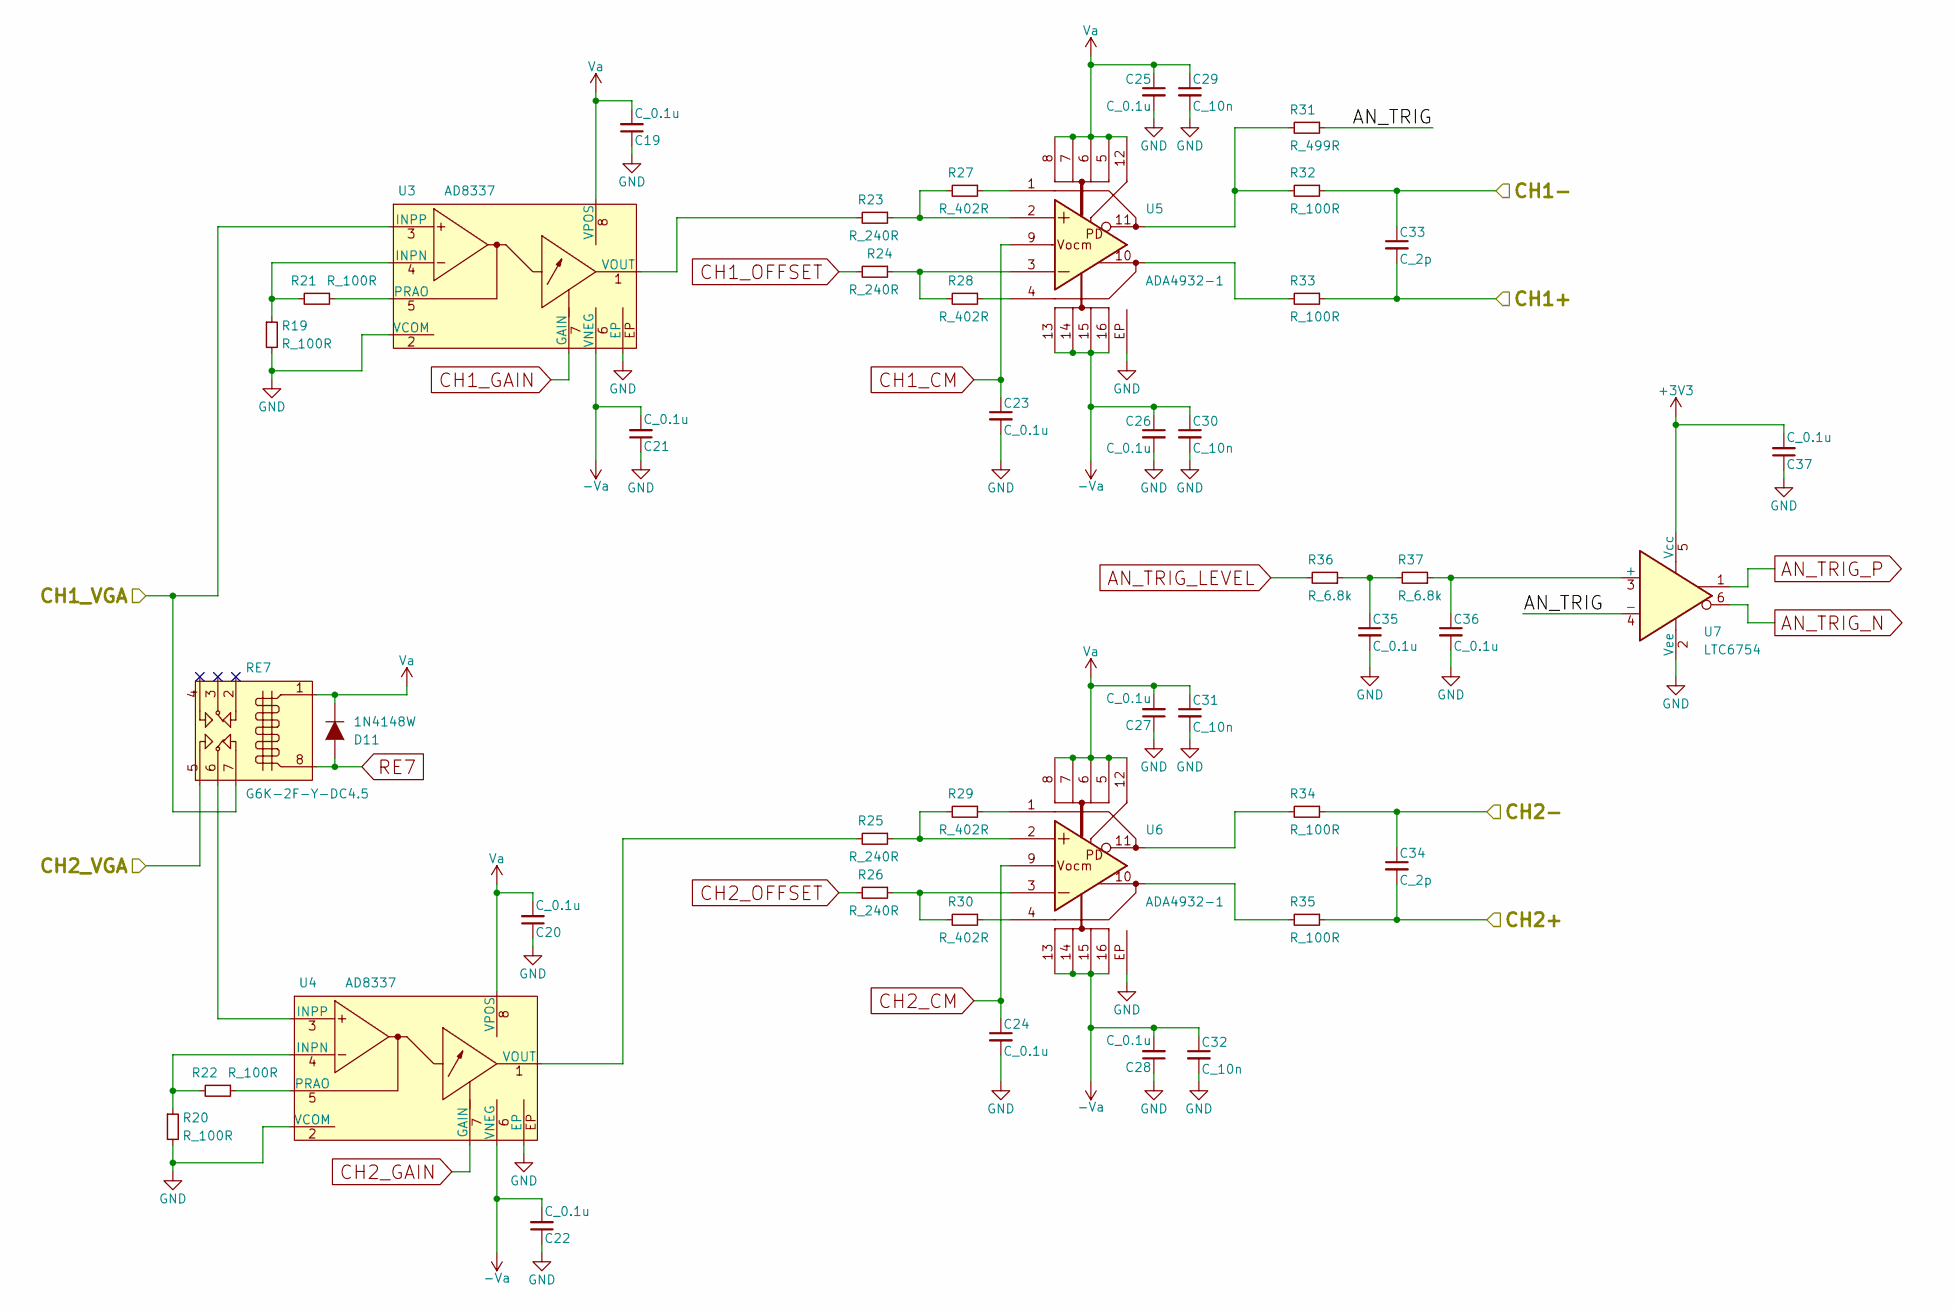
[picture p8: schematic file56785EF9.kicad_sch]

Parts:
C19, C20, C21, C22, C23, C24, C25, C26, C27, C28, C35, C36, C37: C_0.1u; C_0603; MFG Part# C0603C104K4RACTU
C29, C30, C31, C32: C_10n; C_0402; MFG Part# 885012205012
C33, C34: C_2p; C_0603; MFG Part# C1608C0G2A020C080AA
D11: 1N4148W; SOD123; MFG Part# 1N4148W-7-F
R19, R20, R21, R22, R32, R33, R34, R35: R_100R; R_0603; MFG Part# ERJ-3EKF1000V
R23, R24, R25, R26: R_240R; R_0603; MFG Part# ERJ-3EKF2400V
R27, R28, R29, R30: R_402R; R_0603; MFG Part# ERJ-3EKF4020V
R31: R_499R; R_0603; MFG Part# ERJ-3EKF4990V
R36, R37: R_6.8k; R_0603; MFG Part# ERJ-3EKF6801V
RE7: G6K-2F-Y-DC4.5; G6K-2F-Y; MFG Part# G6K-2F-Y-DC4.5
U3, U4: AD8337; CP-8-2; MFG Part# AD8337BCPZ-REEL7
U5, U6: ADA4932-1; CP-16-2; MFG Part# ADA4932-1YCPZ-R7
U7: LTC6754; SC70-6; MFG Part# LTC6754HSC6#TRMPBF

Connections:
+3V3: C37.2, U7.5 (Vcc)
-Va: C21.2, C22.2, C26.1, C28.2, C30.1, C32.1, U3.6 (VNEG), U4.6 (VNEG), U5.13 (-Vs), U5.14 (-Vs), U5.15 (-Vs), U5.16 (-Vs), U6.13 (-Vs), U6.14 (-Vs), U6.15 (-Vs), U6.16 (-Vs)
AN_TRIG: R31.1, U7.4 (-)
AN_TRIG_LEVEL: R36.2
AN_TRIG_N: U7.6
AN_TRIG_P: U7.1
CH1+: C33.2, R33.1
CH1-: C33.1, R32.1
CH1_CM: C23.1, U5.9 (Vocm)
CH1_GAIN: U3.7 (GAIN)
CH1_OFFSET: R24.2
CH1_VGA: RE7.7, U3.3 (INPP)
CH2+: C34.2, R35.1
CH2-: C34.1, R34.1
CH2_CM: C24.1, U6.9 (Vocm)
CH2_GAIN: U4.7 (GAIN)
CH2_OFFSET: R26.2
CH2_VGA: RE7.5
GND: C19.1, C20.1, C21.1, C22.1, C23.2, C24.2, C25.2, C26.2, C27.1, C28.1, C29.2, C30.2, C31.2, C32.2, C35.2, C36.2, C37.1, R19.2, R20.2, U3.2 (VCOM), U3.EP, U4.2 (VCOM), U4.EP, U5.EP, U6.EP, U7.2 (Vee)
unnamed: C35.1, R36.1, R37.2
unnamed: C36.1, R37.1, U7.3 (+)
unnamed: R19.1, R21.2, U3.4 (INPN)
unnamed: R20.1, R22.2, U4.4 (INPN)
unnamed: R21.1, U3.5 (PRAO)
unnamed: R22.1, U4.5 (PRAO)
unnamed: R23.1, R27.2, U5.2 (+IN)
unnamed: R23.2, U3.1 (VOUT)
unnamed: R24.1, R28.2, U5.3 (-IN)
unnamed: R25.1, R29.2, U6.2 (+IN)
unnamed: R25.2, U4.1 (VOUT)
unnamed: R26.1, R30.2, U6.3 (-IN)
unnamed: R27.1, U5.1 (-FB)
unnamed: R28.1, U5.4 (+FB)
unnamed: R29.1, U6.1 (-FB)
unnamed: R30.1, U6.4 (+FB)
unnamed: R31.2, R32.2, U5.11 (-OUT)
unnamed: R33.2, U5.10 (+OUT)
unnamed: R34.2, U6.11 (-OUT)
unnamed: R35.2, U6.10 (+OUT)
unnamed: RE7.6, U4.3 (INPP)
RE7: D11.2 (A), RE7.8
Va: C19.2, C20.2, C25.1, C27.2, C29.1, C31.1, D11.1 (K), RE7.1, U3.8 (VPOS), U4.8 (VPOS), U5.5 (+Vs), U5.6 (+Vs), U5.7 (+Vs), U5.8 (+Vs), U5.12 (r~PD), U6.5 (+Vs), U6.6 (+Vs), U6.7 (+Vs), U6.8 (+Vs), U6.12 (r~PD)
