cosmopotamian/scopefun-hardware/KiCadSource/rescue-backup/file56A1473D-2025-03-08-01-08-09.sch

## KiCad design KiCadSource/rescue-backup/file56A1473D-2025-03-08-01-08-09.sch (2025-03-08)

Schematic: file56A1473D-2025-03-08-01-08-09.sch

Parts:
AWG1, AWG2: BNC; BNC-5-1634556-0; MFG Part# 5-1634556-0
C90, C91, C92, C93, C94, C95, C96, C97, C98, C99: C_0.1u; C_0603; MFG Part# C0603C104K4RACTU
D48, D49: BAV199; SOT23; MFG Part# BAV199-7-F
D50, D51: ESD7002; SOT323; MFG Part# ESD7002WTT1G
Q6: BSS138BKS; SOT363; MFG Part# BSS138PS,115
R81, R82, R83, R84: R_0R; R_0603; MFG Part# RC0603JR-070RL
R85, R86, R87, R88: R_240R; R_0603; MFG Part# ERJ-3EKF2400V
R89, R90: R_48.7R_0.25W; R_1206; MFG Part# ERJ-8ENF48R7V
R91, R92: R_499R; R_0603; MFG Part# ERJ-3EKF4990V
R93, R95: R_499k; R_0603; MFG Part# ERJ-3EKF4993V
R94, R96: R_22k; R_0603; MFG Part# ERJ-3EKF2202V
R97, R98: R_10k; R_0603; MFG Part# ERJ-3EKF1002V
R99, R102: R_49.9k; R_0603; MFG Part# ERJ-3EKF4992V
R100, R101: R_1.5k; R_0603; MFG Part# ERJ-3EKF1501V
R148, R149, R150, R151: R_100R; R_0603; MFG Part# ERJ-3EKF1000V
RE8, RE9: AQY282SX; SOP-4; MFG Part# AQY282SX
U16: OPA2830; TSSOP8; MFG Part# OPA2830IDGKT
U17, U18: LM393DGK; TSSOP8; MFG Part# LM393DGKR
