cosmopotamian/scopefun-hardware/KiCadSource/rescue-backup/file5696EC3B-2025-03-08-01-08-09.sch

## KiCad design KiCadSource/rescue-backup/file5696EC3B-2025-03-08-01-08-09.sch (2025-03-08)

Schematic: file5696EC3B-2025-03-08-01-08-09.sch

Parts:
C74, C75, C76, C77, C78, C79, C82, C83, C84, C85, C88, C89: C_10n; C_0603; MFG Part# GCM188R72A103KA37J
C80, C81, C86, C87: C_0.1u; C_0603; MFG Part# C0603C104K4RACTU
D29, D30, D31, D32, D33, D34, D35, D36, D37, D38, D39, D40: BAV199; SOT23; MFG Part# BAV199-7-F
D41: ESDA8V2-1J; SOD323; MFG Part# ESDA8V2-1J
D42, D43, D44, D45, D46, D47: ESD7002; SOT323; MFG Part# ESD7002WTT1G
J1: DIL14_RA; MFG Part# 61201421721
R69, R70, R71, R72, R73, R74, R75, R76, R77, R78, R79, R80: R_470R_0.33W; R_0603; MFG Part# SG73P1JTTD4700F
R187, R188, R189, R190, R191, R192, R193, R194, R195, R196, R197, R198: R_56R; R_0603; MFG Part# ERJ-3EKF56R0V
U15: 74AVCH16T245; TSSOP48; MFG Part# SN74AVCH16T245GR
