cosmopotamian/scopefun-hardware/(notices)

Notices in the files:
KiCadSource/rescue-backup/Scopefun_v2-2025-03-08-01-08-09.sch:
Copyright Dejan Priversek 2019
Licensed under CERN OHL v.1.2
KiCadSource/rescue-backup/file56948067-2025-03-08-01-08-09.sch:
Copyright Dejan Priversek 2017
